jaromir-sukuba/Brainfucktor/README.md

Aim of this still unfinished project is to make functional Brainfuck computer in less than 1kB of code, as expected from 1kB challenge on hackaday.io - https://hackaday.io/contest/18215-the-1kb-challenge
Project page of this project is here - https://hackaday.io/project/18445-brainfcktor
