jaromir-sukuba/Brainfucktor/hw/3.pdf

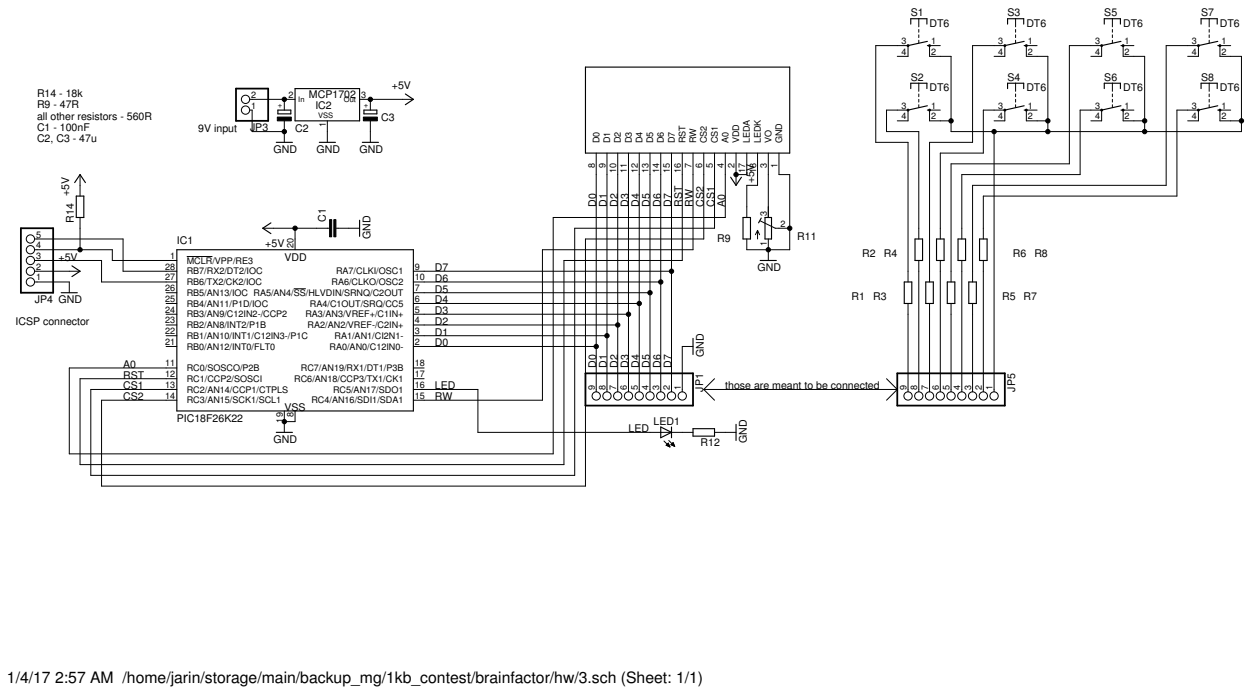
[picture p1: page 1]

18 LED

those are meant to be connected

1/4/17 2:57 AM /home/jarin/storage/main/backup_mg/1kb_contest/brainfactor/hw/3.sch (Sheet: 1/1)
