jaromir-sukuba/Brainfucktor/hw/3_main_a.brd

## EAGLE design hw/3_main_a.brd (2017-01-04)

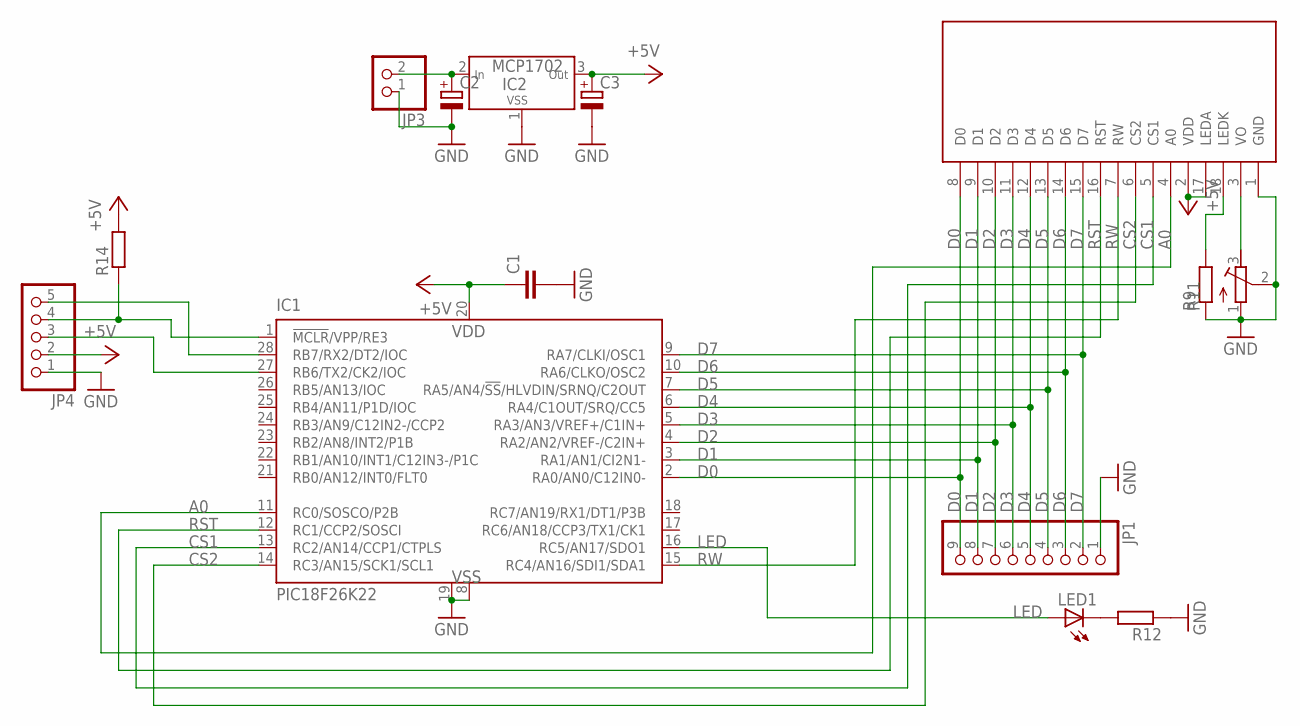
[picture p2: schematic 3_main_a.sch]

Parts:
C1: C-EU025-025X050; C025-025X050
C2, C3: CPOL-EUE2-4; E2-4
IC1: PIC18F26K22; DIL28-3
IC2: MCP1702; TO-92
JP1: PINHD-1X09_2.54-90°; 1X09/90
JP3: PINHD-1X2; 1X02
JP4: PINHD-1X05_2.54-90°; 1X05/90
LCD1: DEM122032
LED1: LED3MM
R9, R12, R14: R_0207; R_0207_BIGPADS
R11: R-TRIMM3339P; RTRIM3339P

Connections:
+5V: C1.1, C3.+, IC1.20 (VDD), IC2.3 (OUT), JP4.2, LCD1.2 (VDD), LCD1.17 (LEDA), R14.P$2 (2)
A0: IC1.11 (RC0/SOSCO/P2B), LCD1.4 (A0)
CS1: IC1.13 (RC2/AN14/CCP1/CTPLS), LCD1.5 (CS1)
CS2: IC1.14 (RC3/AN15/SCK1/SCL1), LCD1.6 (CS2)
D0: IC1.2 (RA0/AN0/C12IN0-), JP1.9, LCD1.8 (D0)
D1: IC1.3 (RA1/AN1/CI2N1-), JP1.8, LCD1.9 (D1)
D2: IC1.4 (RA2/AN2/VREF-/C2IN+), JP1.7, LCD1.10 (D2)
D3: IC1.5 (RA3/AN3/VREF+/C1IN+), JP1.6, LCD1.11 (D3)
D4: IC1.6 (RA4/C1OUT/SRQ/CC5), JP1.5, LCD1.12 (D4)
D5: IC1.7 (RA5/AN4/!SS!/HLVDIN/SRNQ/C2OUT), JP1.4, LCD1.13 (D5)
D6: IC1.10 (RA6/CLKO/OSC2), JP1.3, LCD1.14 (D6)
D7: IC1.9 (RA7/CLKI/OSC1), JP1.2, LCD1.15 (D7)
GND: C1.2, C2.-, C3.-, IC1.8 (VSS), IC1.19 (VSS), IC2.1 (VSS), JP1.1, JP3.1, JP4.1, LCD1.1 (GND), R9.P$1 (1), R11.1 (E), R11.2 (S), R12.P$1 (1)
LED: IC1.16 (RC5/AN17/SDO1), LED1.A
unnamed: LCD1.18 (LEDK), R9.P$2 (2)
unnamed: LCD1.3 (VO), R11.3 (A)
unnamed: LED1.K (C), R12.P$2 (2)
unnamed: C2.+, IC2.2 (IN), JP3.2
unnamed: IC1.1 (!MCLR!/VPP/RE3), JP4.4, R14.P$1 (1)
unnamed: IC1.28 (RB7/RX2/DT2/IOC), JP4.5
unnamed: IC1.27 (RB6/TX2/CK2/IOC), JP4.3
RST: IC1.12 (RC1/CCP2/SOSCI), LCD1.16 (RST)
RW: IC1.15 (RC4/AN16/SDI1/SDA1), LCD1.7 (RW)

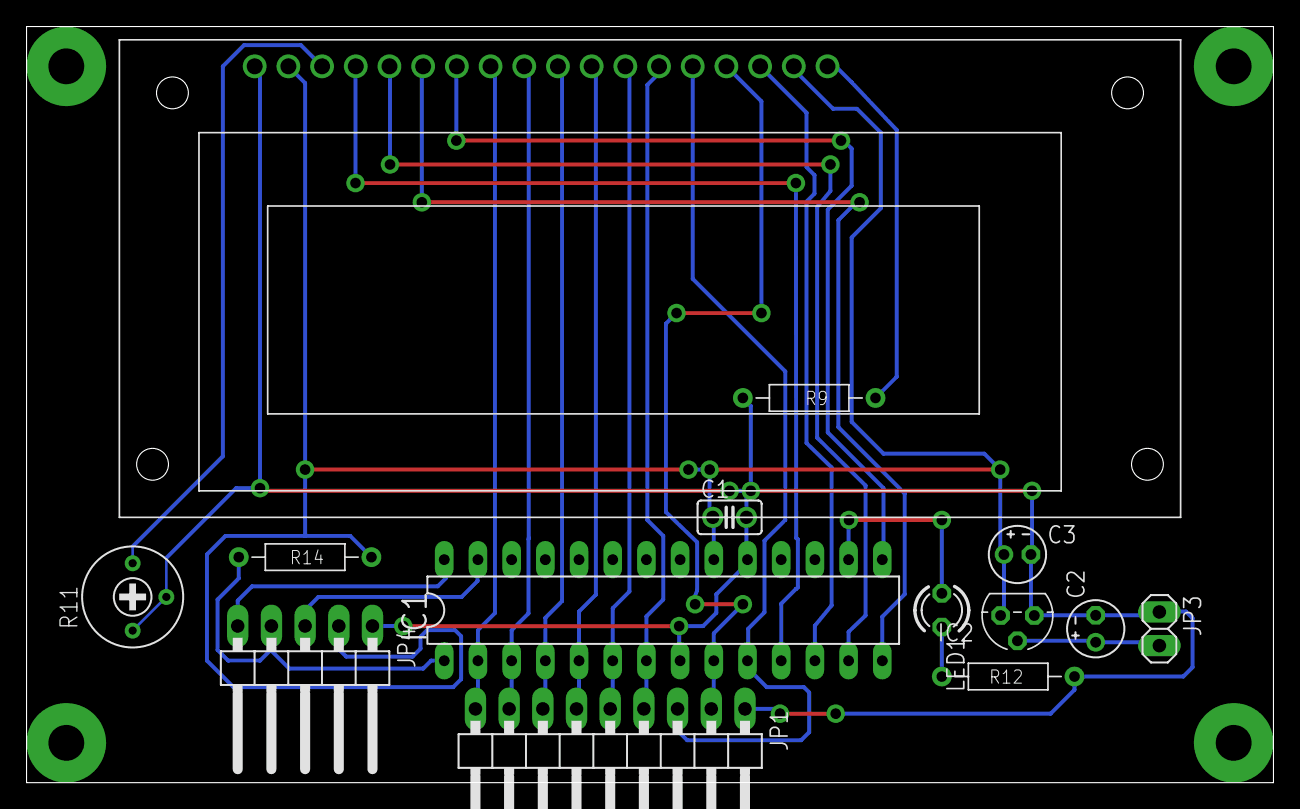
[picture p3: board 3_main_a.brd from above]

Board: 2 copper layers, 94.0 x 57.0 mm, 14 parts (0 on the bottom side), 23 nets.
