jaromir-sukuba/Brainfucktor/hw/3_buttons_a.brd

## EAGLE design hw/3_buttons_a.brd (2017-01-04)

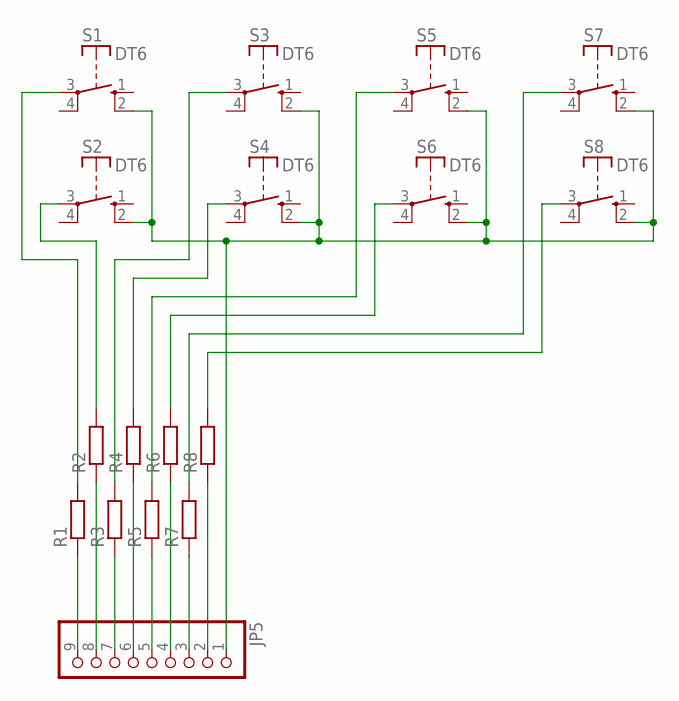
[picture p4: schematic 3_buttons_a.sch]

Parts:
JP5: PINHD-1X09_2.54-90°; 1X09/90
R1, R2, R3, R4, R5, R6, R7, R8: R_0207; R_0207_BIGPADS
S1, S2, S3, S4, S5, S6, S7, S8: DT6

Connections:
unnamed: JP5.9, R1.P$1 (1)
unnamed: JP5.8, R2.P$1 (1)
unnamed: JP5.7, R3.P$1 (1)
unnamed: JP5.6, R4.P$1 (1)
unnamed: JP5.5, R5.P$1 (1)
unnamed: JP5.4, R6.P$1 (1)
unnamed: JP5.3, R7.P$1 (1)
unnamed: JP5.2, R8.P$1 (1)
unnamed: JP5.1, S1.2 (S), S2.2 (S), S3.2 (S), S4.2 (S), S5.2 (S), S6.2 (S), S7.2 (S), S8.2 (S)
unnamed: R1.P$2 (2), S1.3
unnamed: R2.P$2 (2), S2.3
unnamed: R3.P$2 (2), S3.3
unnamed: R4.P$2 (2), S4.3
unnamed: R5.P$2 (2), S5.3
unnamed: R6.P$2 (2), S6.3
unnamed: R7.P$2 (2), S7.3
unnamed: R8.P$2 (2), S8.3

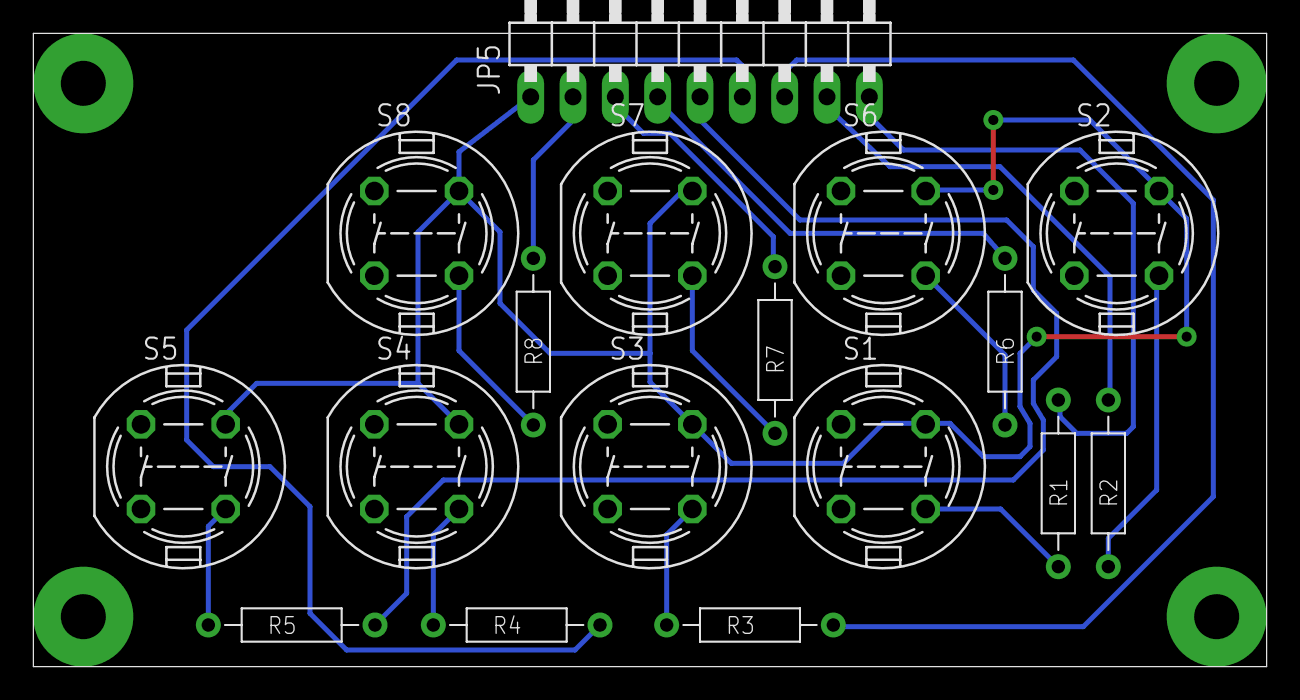
[picture p5: board 3_buttons_a.brd from above]

Board: 2 copper layers, 74.0 x 38.0 mm, 17 parts (0 on the bottom side), 17 nets.
